xayzyt/STM32_Smart_Car_1.5/README.md

# STM32_Smart_Car_1.5
初学者的第一个小车项目，该小车有超声波跟随，蓝牙控制，超声波避障，红外循迹四个功能，内含原理图及PCB，以及硬件全部资料和软件源码。
