xayzyt/STM32_Smart_Car_1.5/04小车PCB硬件资料(你要的PCB电路板资料)/小车PCB资料_V1.5/02_PCB工程文件_STM32小车V1.5正式版(这是工程文件把这个导入立创就可以修改编辑)/如何使用步骤.docx

1. 登录立创EDA

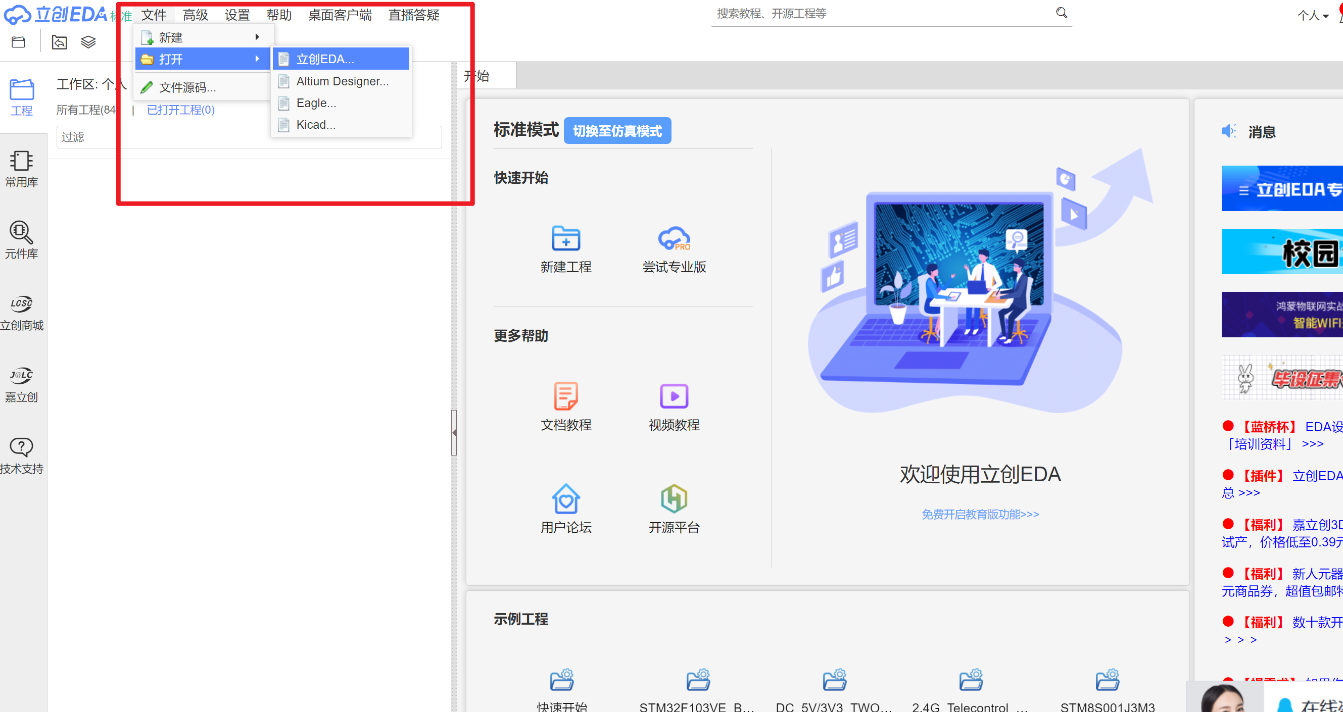
[picture p2: figure]

2. 选择文件

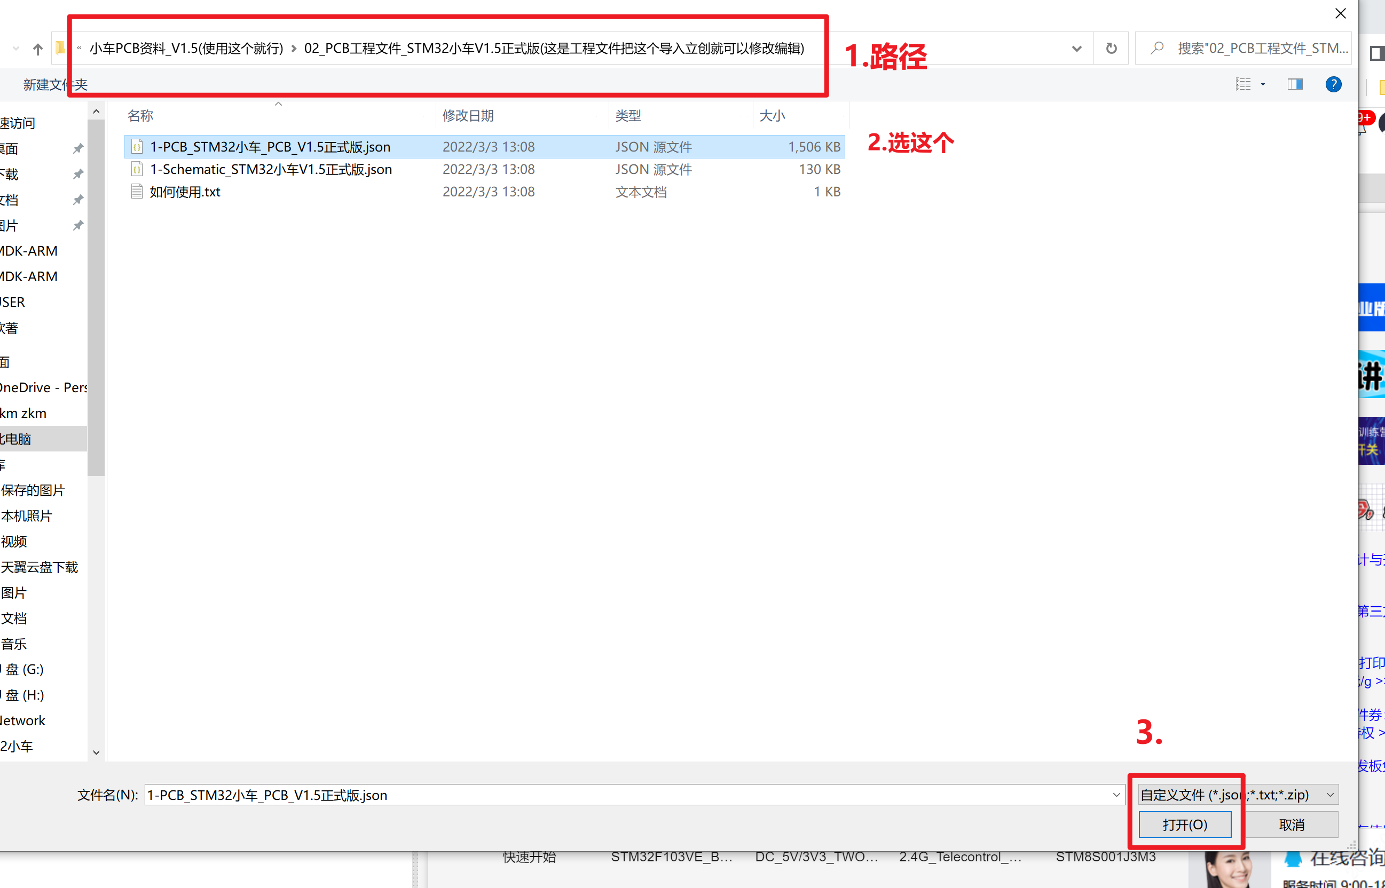
[picture p3: figure]

3. 选择保存新工程里

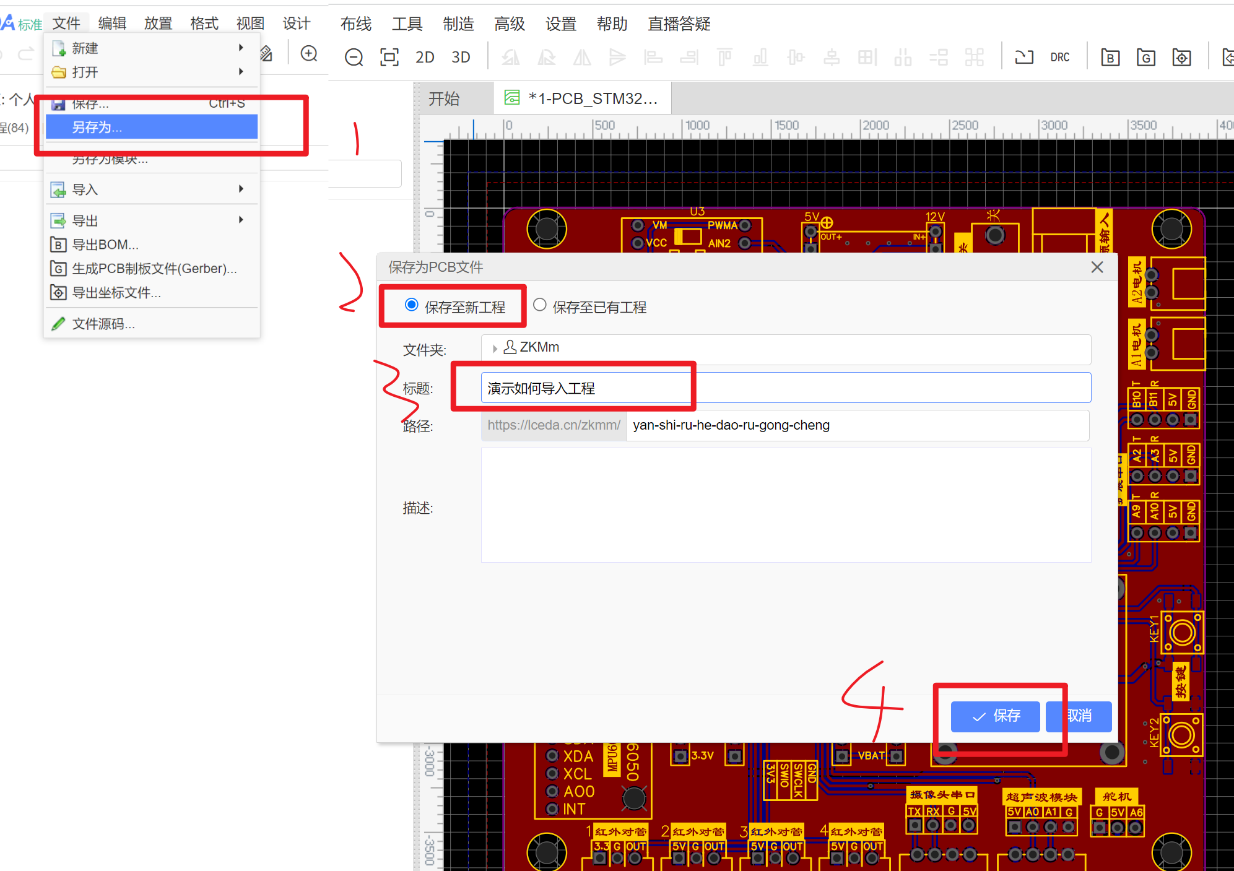
[picture p4: figure]

4. 导入下一原理图

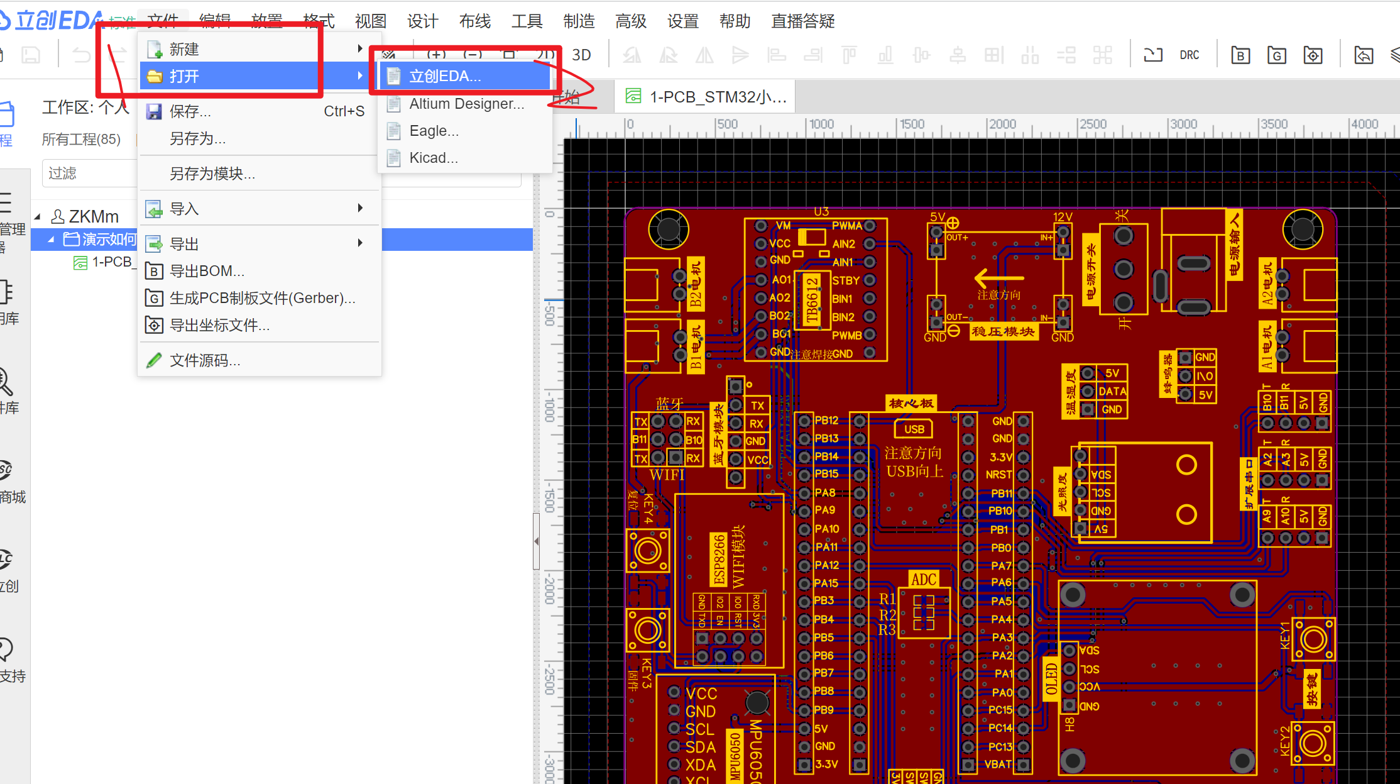
[picture p5: figure]

选择原理图

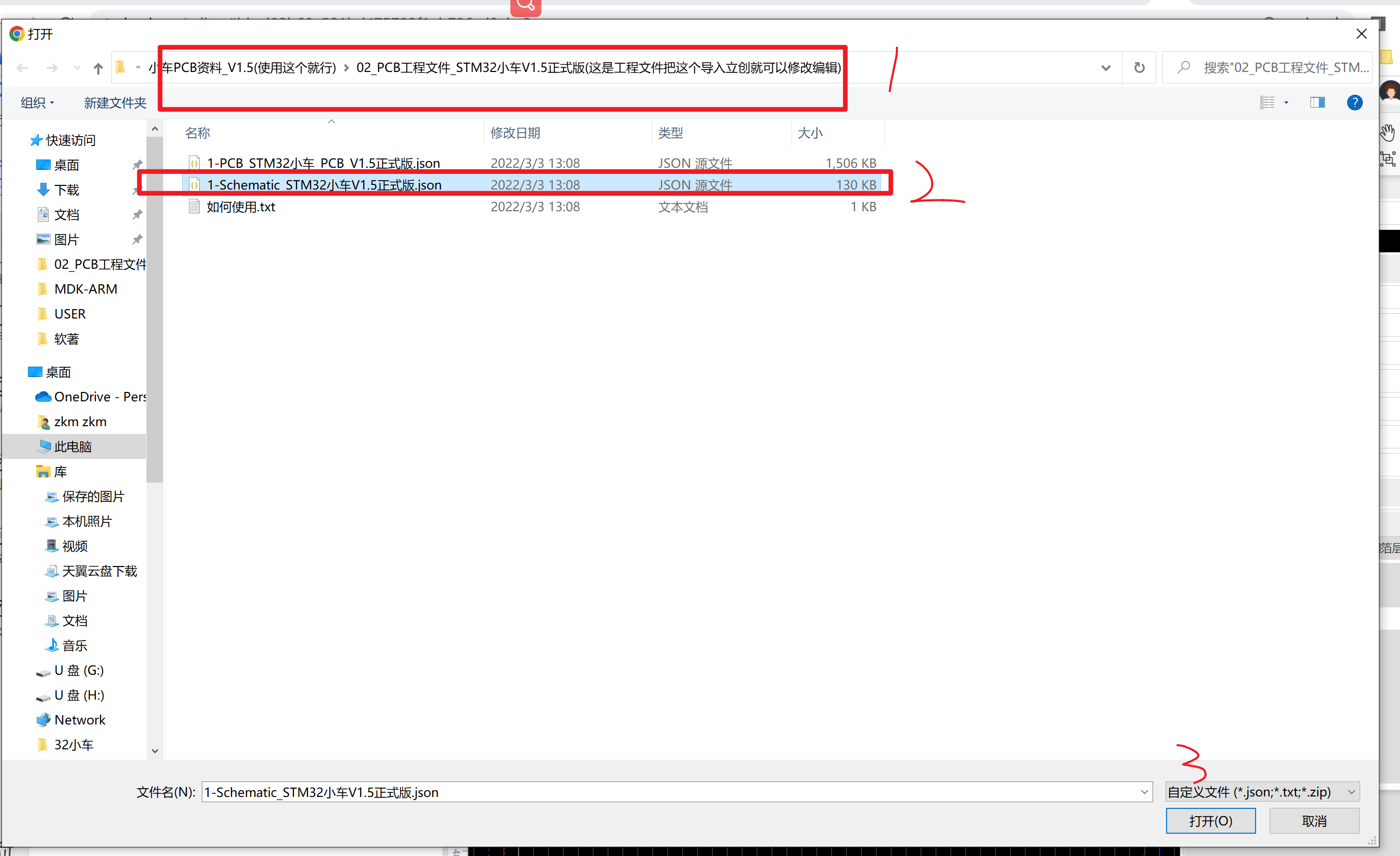
[picture p6: figure]
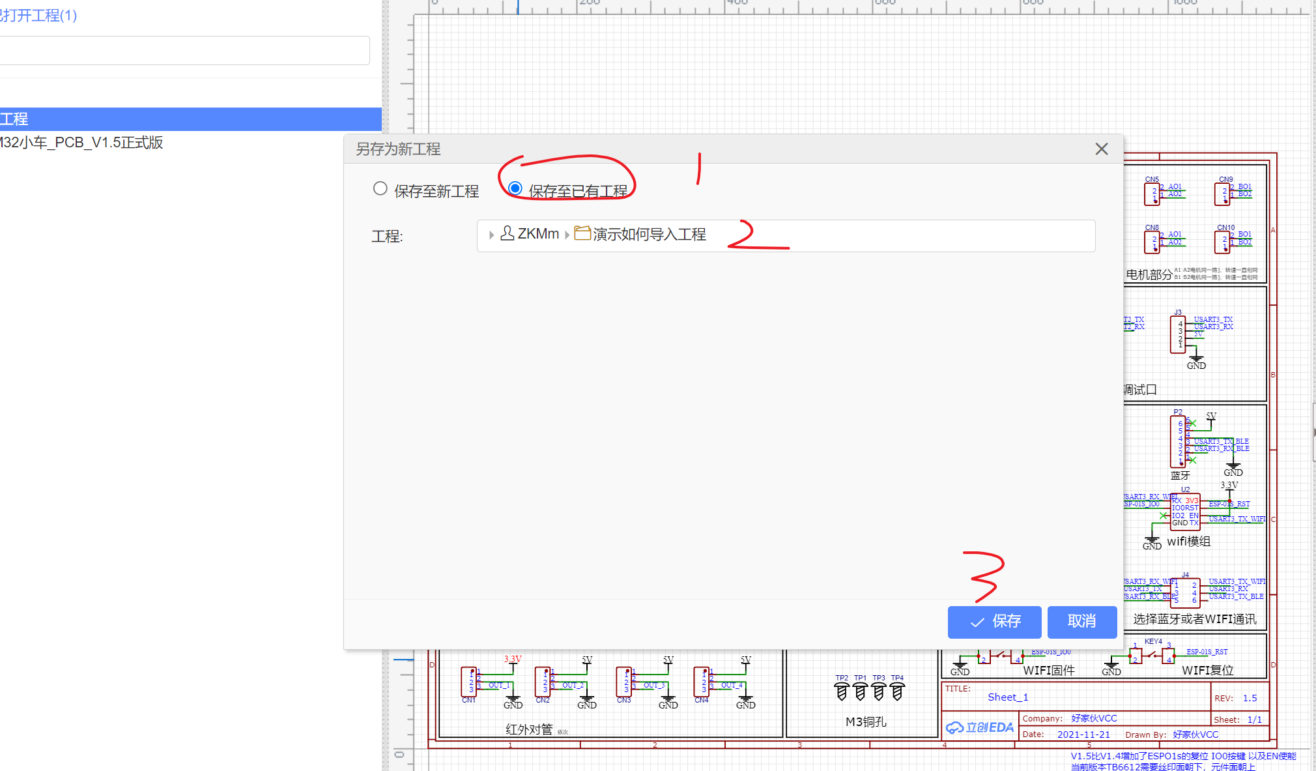
[picture p7: figure]
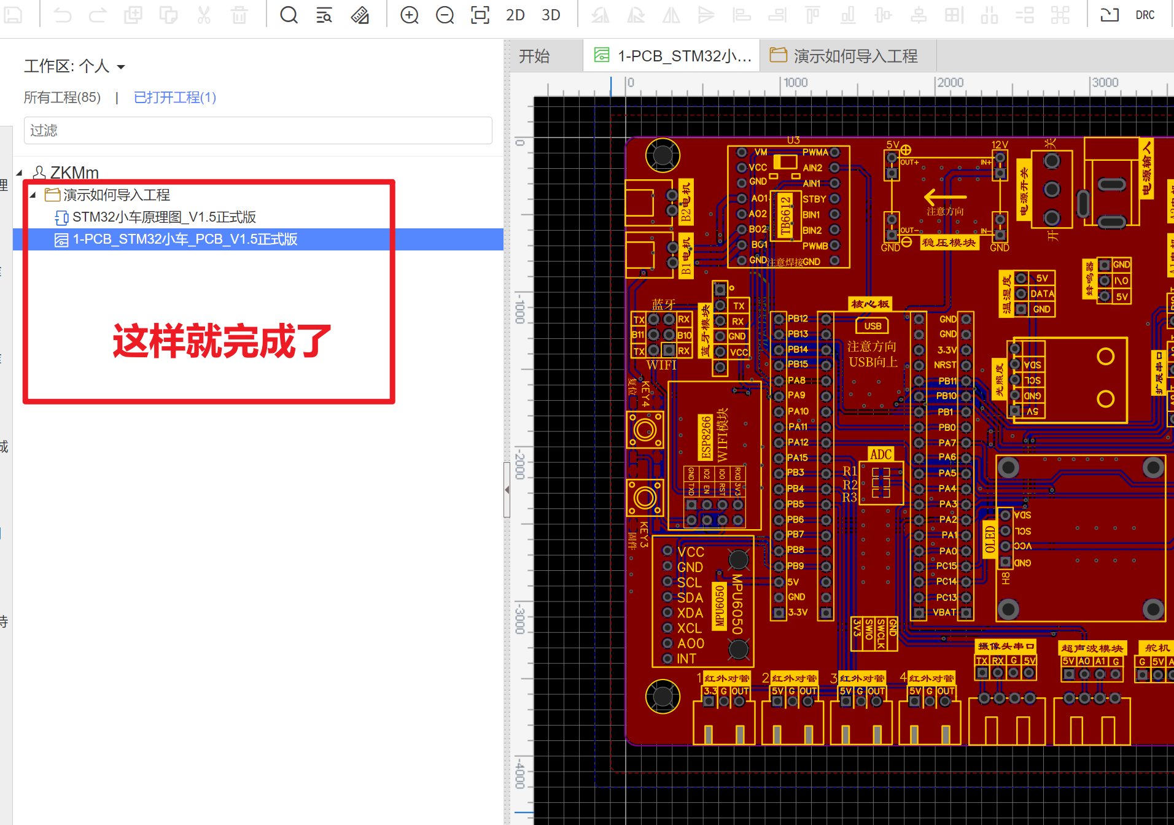
[picture p8: figure]
