xayzyt/STM32_Smart_Car_1.5/04小车PCB硬件资料(你要的PCB电路板资料)/小车PCB资料_V1.5/PCB3D预览(这个图没有什么用).png

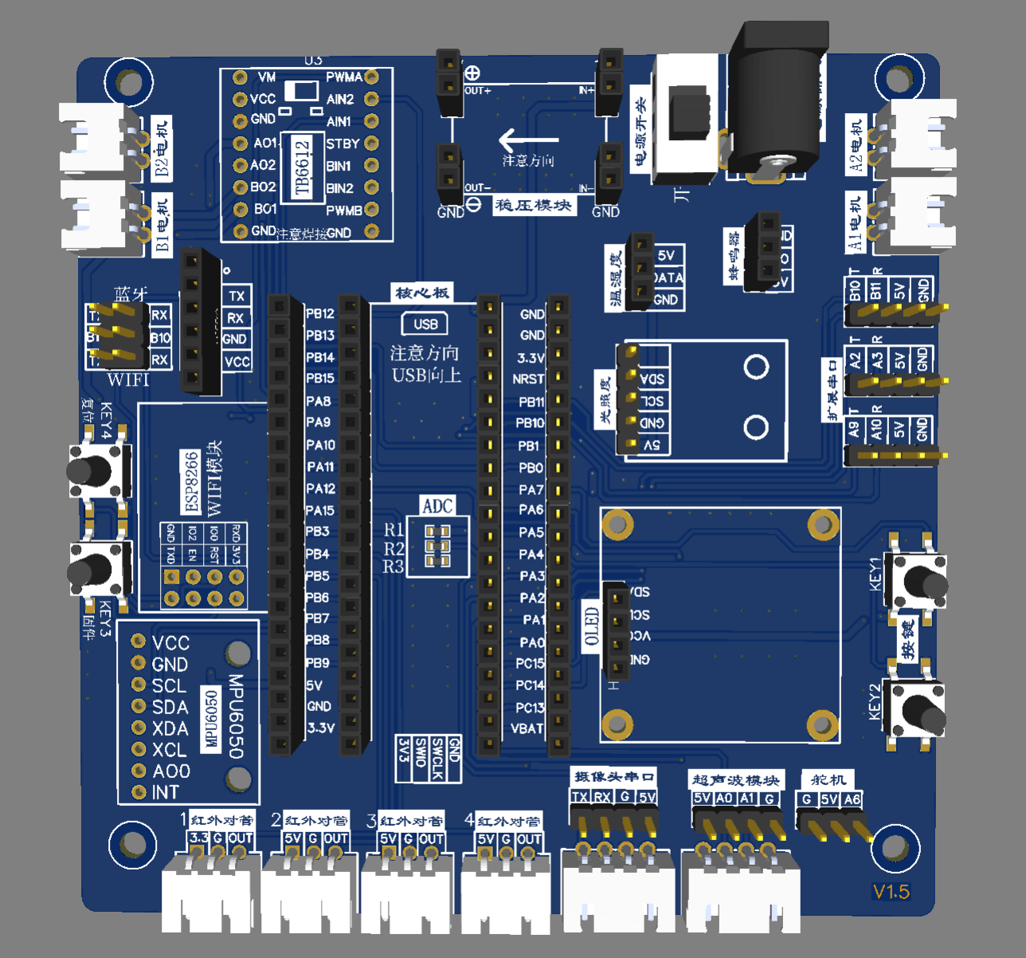
04小车PCB硬件资料(你要的PCB电路板资料)/小车PCB资料_V1.5/PCB3D预览(这个图没有什么用).png
