xayzyt/STM32_Smart_Car_1.5/04小车PCB硬件资料(你要的PCB电路板资料)/小车PCB资料_V1.5/无模块(焊接前大家一定看看这个).png

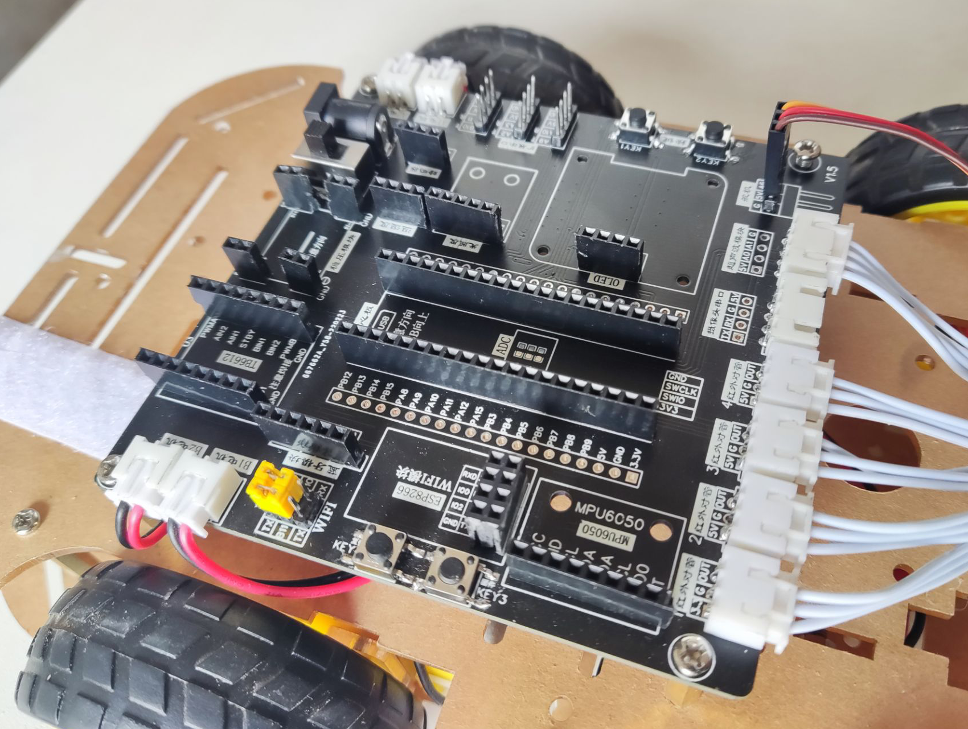
04小车PCB硬件资料(你要的PCB电路板资料)/小车PCB资料_V1.5/无模块(焊接前大家一定看看这个).png
