xayzyt/STM32_Smart_Car_1.5/04小车PCB硬件资料(你要的PCB电路板资料)/小车PCB资料_V1.5/04_所有物料清单(要买的零件都在这里).xlsx

类别 | 元件名称 | 数量 | 型号 | 注意事项
电子模块 | STM32f103c8t6最小系统板 | 1 | 芯片是:STM32F103C8T6!!!(大佬随意) | 也不能买特别便宜的，有的存在问题
 | OLED显示屏模块 0.96寸 IIC/SPI | 1
 | HC-SR04 超声波测距模块 | 1
 | 寻迹传感器 TCRT5000红外反射传感器 | 4 |  | 可以买5个，实际使用4个
 | HC-05 主从机一体蓝牙串口透传模块 | 1 | 要板子带个小按键的方便一点 | 现在买HC-05都是新版，新版用法我在视频补充了
 | TB6612FNG电机驱动模块 | 1
 | DC-DC降压板3A/5A稳压电源模块MP1584 | 1 | 3A降压5V输出 | 一定要大概是这个尺寸：22.3mm*17mm
 | SG90 9g舵机 固定翼航模遥控飞机 180度舵机 | 1 | 一定是180度的
 | 12v锂电池组18650充电带保护板大容量电瓶通用移动电源便携蓄电池 | 1 | 最好带充电器
电源 | 智能小车底盘/寻迹小车/机器人小车底盘/测速/送电池盒2 4 WD小车 |  | 必须带4个电机，双层更好
组装小车结构 | 固定超声波传感器支架 | 1 | HC-SR04 超声波固定支架
 | 常用M3螺丝包 螺母 3*5 3*8 3*10 3*12 3*12 圆头平头螺丝 | 1 | 无(就是架板子用，不买也行)
 | 常用M3 铜柱 包 M3*5 6 8 10 12 15 +6 双通 M3螺母 螺丝 | 1 | 无(就是架板子用，不买也行)
 | SG90舵机支架 | 1 | SG90舵机云台支架
 | XH2.54MM-2P单头连接线 端子线 | 4 | 长度20-30CM左右
线材 | XH2.54 单头电子线 红白排线 长20CM | 4 | 3P 双头长度：20CM左右
 | XH2.54 单头电子线 红白排线 长20CM | 1 | 4P双头长度：20CM左右
 | XH2.54接插件 2.54mm | 4 | 3P 弯针
PCB | XH2.54接插件 2.54mm | 2 | 4P 弯针
 | 母座 弯插/弯针 2.5mm 2Pin位 | 4 | 2P 弯针
 | 间距2.54MM 单排直插母座 | 2 | 间距2.54MM 1*20
 | 间距2.54MM 单排直插母座 | 3 | 间距2.54MM 1*8
 | 间距2.54MM 单排直插母座 | 1 | 间距2.54MM 2*4
 | 双排针 间距2.54MM | 1 | 间距2.54MM 2*3
 | 间距2.54MM 单排直插母座 | 1 | 间距2.54MM 1*6
 | 间距2.54MM 单排直插母座 | 4 | 间距2.54MM 1*2
 | 间距2.54MM 单排直插母座 | 1 | 间距2.54MM 1*4
 | 间距2.54MM 单排直插母座 | 1 | 间距2.54MM 1*5
 | 间距2.54MM 单排直插母座 | 2 | 间距2.54MM 1*3
 | 6*6*7mm 轻触按键 | 4 | 贴片封装 | 至少买4个(V1.5版PCB焊接4个，如果V1.4就两个就行)
 | DC电源插座 内径:2mm 外径:6.3mm | 1 | 插件
 | 滑动开关 插件大电流拨动开关 SS-12D10L2.5 | 1 | 插件
 | 0603封装20K电阻 | 2 | 贴片封装
 | 0603封装10K电阻 | 1 | 贴片封装
 | 跳线帽 短路帽 间距2.54MM | 2 | 无
 | 单排针 间距2.54MM | 2 | 间距2.54MM 1*10 | 排针是可以自己掰的，比如这个掰成1*2的焊接在稳压电源模块上
调试与烧录工具 | ST-LINK V2 STM8/STM32仿真器编程器 | 1 | ST-LINK V2(第一次使用需要在电脑安装驱动) | 这是下载程序用的(提高调试效率)
 | USB转TTL CH340模块 USB转串口 | 1 | 第一次使用需要在电脑安装驱动 | 这个是单片机和电脑串口通讯使用(调试串口必备)
 | 杜邦线 母对母 公对母公对公40P彩色排线连接线10/15/30/20/40CM | 1 | 母对母30CM 10根以上
胶带 | 用黑的可以做循迹赛道
