xayzyt/STM32_Smart_Car_1.5/05小车结构组装资料/PCB和超声波安装.png

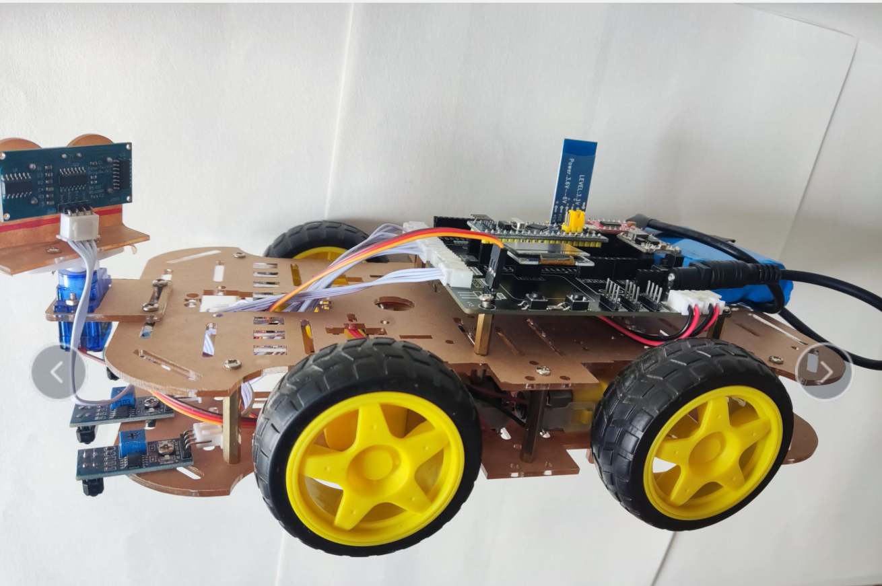
05小车结构组装资料/PCB和超声波安装.png
