xayzyt/STM32_Smart_Car_1.5/05小车结构组装资料/红外对管安装.png

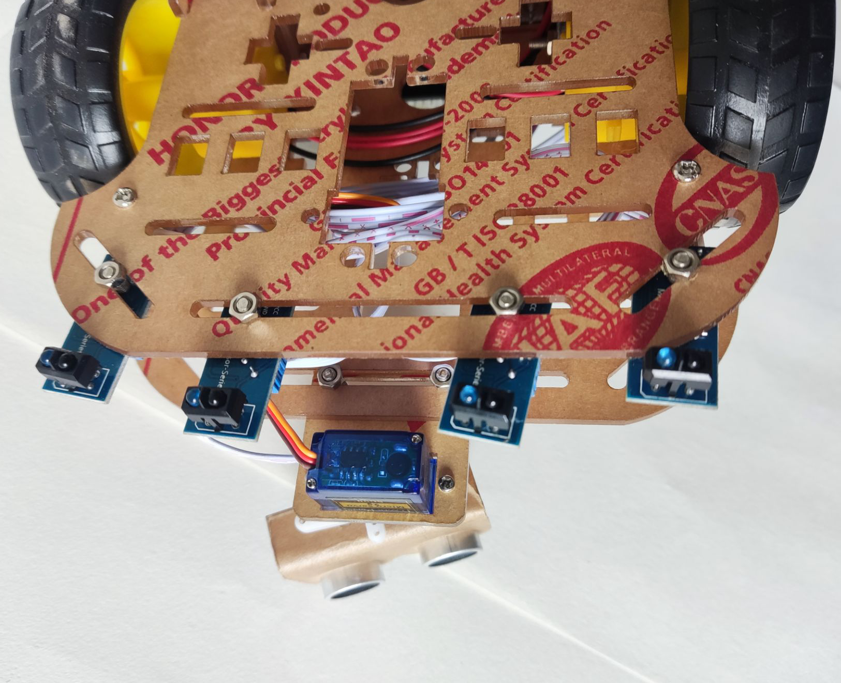
05小车结构组装资料/红外对管安装.png
