xayzyt/STM32_Smart_Car_1.5/05小车结构组装资料/组装好的侧视图.png

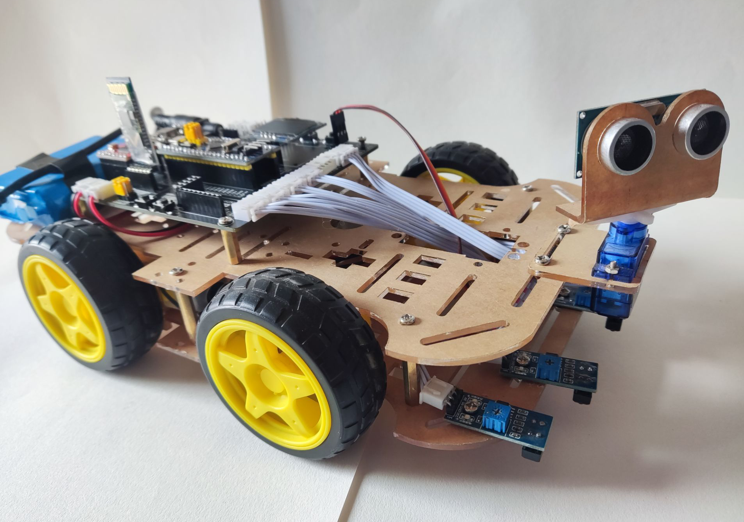
05小车结构组装资料/组装好的侧视图.png
