xayzyt/STM32_Smart_Car_1.5/04小车PCB硬件资料(你要的PCB电路板资料)/小车PCB资料_V1.5/01_原理图_STM32小车V1.5正式版.pdf

5V

## GND

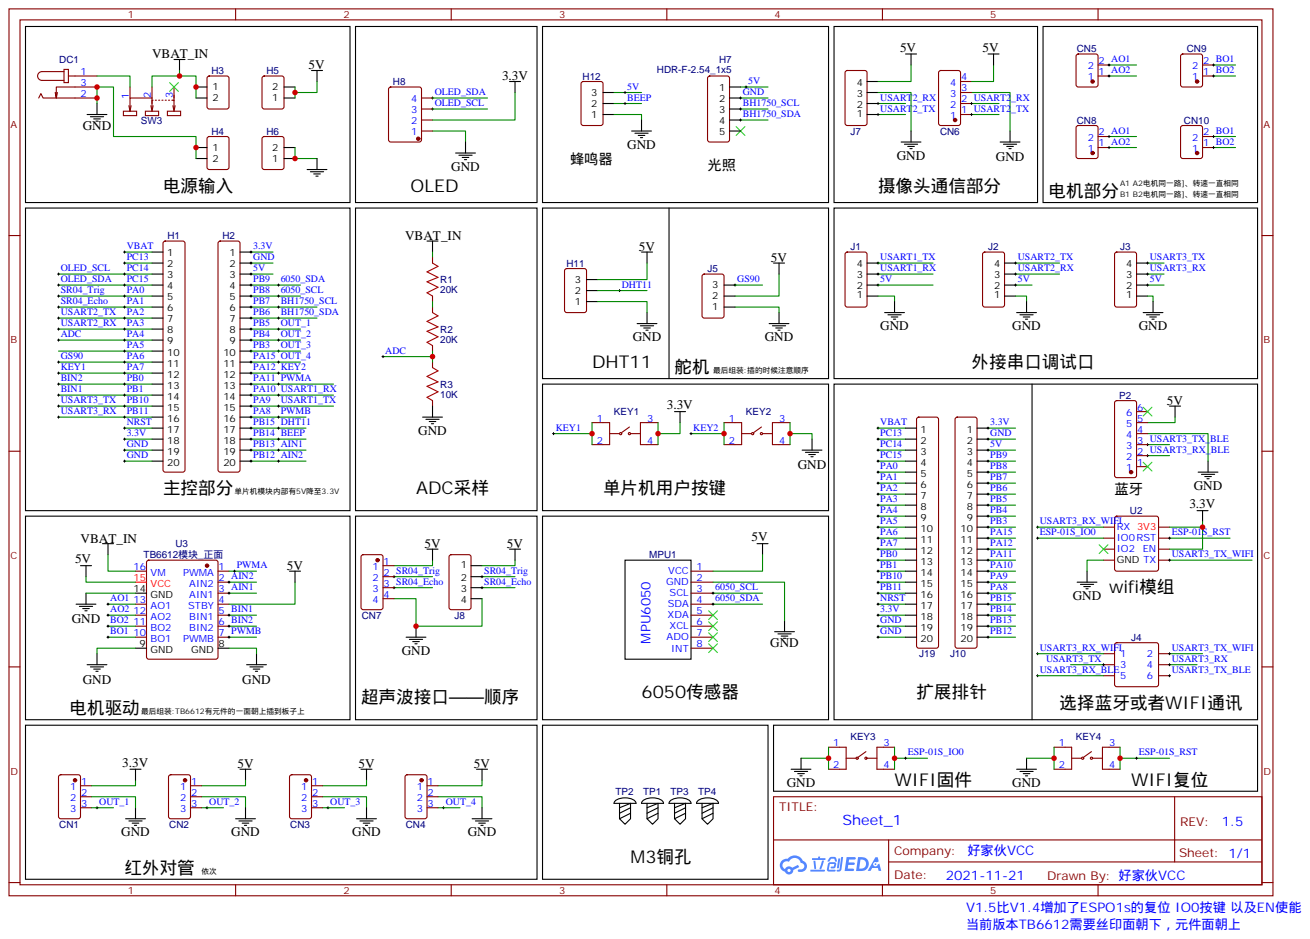
[picture p15: page 1]
