xayzyt/STM32_Smart_Car_1.5/01程序资料/HARDWARE/TIMER/timer.c

#include "timer.h"
#include "led.h"
#include "usart.h"
#include "delay.h"


void TIM3_Int_Init(u16 arr,u16 psc)
{
  TIM_TimeBaseInitTypeDef  TIM_TimeBaseStructure;
	NVIC_InitTypeDef NVIC_InitStructure;

	RCC_APB1PeriphClockCmd(RCC_APB1Periph_TIM3, ENABLE); //时钟使能

	TIM_TimeBaseStructure.TIM_Period = arr; //设置在下一个更新事件装入活动的自动重装载寄存器周期的值	 计数到5000为500ms
	TIM_TimeBaseStructure.TIM_Prescaler =psc; //设置用来作为TIMx时钟频率除数的预分频值  10Khz的计数频率  
	TIM_TimeBaseStructure.TIM_ClockDivision = 0; //设置时钟分割:TDTS = Tck_tim
	TIM_TimeBaseStructure.TIM_CounterMode = TIM_CounterMode_Up;  //TIM向上计数模式
	TIM_TimeBaseInit(TIM3, &TIM_TimeBaseStructure); //根据TIM_TimeBaseInitStruct中指定的参数初始化TIMx的时间基数单位
 
	TIM_ITConfig(TIM3,TIM_IT_Update,ENABLE ); //使能指定的TIM3中断,允许更新中断

	NVIC_InitStructure.NVIC_IRQChannel = TIM3_IRQn;  //TIM3中断
	NVIC_InitStructure.NVIC_IRQChannelPreemptionPriority = 0;  //先占优先级0级
	NVIC_InitStructure.NVIC_IRQChannelSubPriority = 3;  //从优先级3级
	NVIC_InitStructure.NVIC_IRQChannelCmd = ENABLE; //IRQ通道被使能
	NVIC_Init(&NVIC_InitStructure);  //根据NVIC_InitStruct中指定的参数初始化外设NVIC寄存器

	TIM_Cmd(TIM3, ENABLE);  //使能TIMx外设
							 
}
//定时器3中断服务程序
void TIM3_IRQHandler(void)   //TIM3中断
{
	if (TIM_GetITStatus(TIM3, TIM_IT_Update) != RESET) //检查指定的TIM中断发生与否:TIM 中断源 
		{
		TIM_ClearITPendingBit(TIM3, TIM_IT_Update  );  //清除TIMx的中断待处理位:TIM 中断源 
		
		}
}




//舵机TIM3 PWM部分初始化 
//PWM输出初始化
//arr：自动重装值
//psc：时钟预分频数
void TIM3_PWM_Init(u16 arr,u16 psc)
{  
	GPIO_InitTypeDef GPIO_InitStructure;
	TIM_TimeBaseInitTypeDef  TIM_TimeBaseStructure;
	TIM_OCInitTypeDef  TIM_OCInitStructure;
	

	RCC_APB1PeriphClockCmd(RCC_APB1Periph_TIM3, ENABLE);	//使能定时器3时钟
 	RCC_APB2PeriphClockCmd(RCC_APB2Periph_GPIOA  | RCC_APB2Periph_AFIO, ENABLE);  //使能GPIO外设和AFIO复用功能模块时钟
	
 
 
   //设置该引脚为复用输出功能,输出TIM3 CH1的PWM脉冲波形	GPIOA.6
	GPIO_InitStructure.GPIO_Pin = GPIO_Pin_6; //TIM3_CH1
	GPIO_InitStructure.GPIO_Mode = GPIO_Mode_AF_PP;  //复用推挽输出
	GPIO_InitStructure.GPIO_Speed = GPIO_Speed_50MHz;
	GPIO_Init(GPIOA, &GPIO_InitStructure);//初始化GPIO
 
   //初始化TIM3
	TIM_TimeBaseStructure.TIM_Period = arr; //设置在下一个更新事件装入活动的自动重装载寄存器周期的值
	TIM_TimeBaseStructure.TIM_Prescaler =psc; //设置用来作为TIMx时钟频率除数的预分频值 
	TIM_TimeBaseStructure.TIM_ClockDivision = 0; //设置时钟分割:TDTS = Tck_tim
	TIM_TimeBaseStructure.TIM_CounterMode = TIM_CounterMode_Up;  //TIM向上计数模式
	TIM_TimeBaseInit(TIM3, &TIM_TimeBaseStructure); //根据TIM_TimeBaseInitStruct中指定的参数初始化TIMx的时间基数单位
	
	//初始化TIM3 Channel1 PWM模式	 
	TIM_OCInitStructure.TIM_OCMode = TIM_OCMode_PWM2; //选择定时器模式:TIM脉冲宽度调制模式2
 	TIM_OCInitStructure.TIM_OutputState = TIM_OutputState_Enable; //比较输出使能
	TIM_OCInitStructure.TIM_OCPolarity = TIM_OCPolarity_Low; //输出极性:TIM输出比较极性低
	TIM_OC1Init(TIM3, &TIM_OCInitStructure);  //根据T指定的参数初始化外设TIM3 OC1

	TIM_OC1PreloadConfig(TIM3, TIM_OCPreload_Enable);  //使能TIM3在CCR1上的预装载寄存器
 
	TIM_Cmd(TIM3, ENABLE);  //使能TIM3
	

}


//TIM1 PWM部分初始化 
//PWM输出初始化
//arr：自动重装值
//psc：时钟预分频数
void TIM1_PWM_Init(u16 arr,u16 psc)
{  
	GPIO_InitTypeDef GPIO_InitStructure;
	TIM_TimeBaseInitTypeDef  TIM_TimeBaseStructure;
	TIM_OCInitTypeDef  TIM_OCInitStructure;
	

	RCC_APB2PeriphClockCmd(RCC_APB2Periph_TIM1, ENABLE);	//使能定时器1时钟
 	RCC_APB2PeriphClockCmd(RCC_APB2Periph_GPIOA  | RCC_APB2Periph_AFIO, ENABLE);  //使能GPIO外设和AFIO复用功能模块时钟
	
	//设置该引脚为复用输出功能,输出TIM1 CH1的PWM脉冲波形	GPIOA.8
	GPIO_InitStructure.GPIO_Pin = GPIO_Pin_8; //TIM1_CH1
	GPIO_InitStructure.GPIO_Mode = GPIO_Mode_AF_PP;  //复用推挽输出
	GPIO_InitStructure.GPIO_Speed = GPIO_Speed_50MHz;
	GPIO_Init(GPIOA, &GPIO_InitStructure);//初始化GPIO
 
   //设置该引脚为复用输出功能,输出TIM1 CH4的PWM脉冲波形	GPIOA.11
	GPIO_InitStructure.GPIO_Pin = GPIO_Pin_11; //TIM1_CH4
	GPIO_InitStructure.GPIO_Mode = GPIO_Mode_AF_PP;  //复用推挽输出
	GPIO_InitStructure.GPIO_Speed = GPIO_Speed_50MHz;
	GPIO_Init(GPIOA, &GPIO_InitStructure);//初始化GPIO
  
 
   //初始化TIM1时基单元
	TIM_TimeBaseStructure.TIM_Period = arr; //设置在下一个更新事件装入活动的自动重装载寄存器周期的值
	TIM_TimeBaseStructure.TIM_Prescaler =psc; //设置用来作为TIMx时钟频率除数的预分频值 
	TIM_TimeBaseStructure.TIM_ClockDivision = 0; //设置时钟分割:TDTS = Tck_tim
	TIM_TimeBaseStructure.TIM_CounterMode = TIM_CounterMode_Up;  //TIM向上计数模式
	TIM_TimeBaseInit(TIM1, &TIM_TimeBaseStructure); //根据TIM_TimeBaseInitStruct中指定的参数初始化TIMx的时间基数单位
	
	//初始化TIM1 Channel1 PWM模式	 
	TIM_OCInitStructure.TIM_OCMode = TIM_OCMode_PWM2; //选择定时器模式:TIM脉冲宽度调制模式2
 	TIM_OCInitStructure.TIM_OutputState = TIM_OutputState_Enable; //比较输出使能
	TIM_OCInitStructure.TIM_OCPolarity = TIM_OCPolarity_High; //输出极性:TIM输出比较极性高
	TIM_OC1Init(TIM1, &TIM_OCInitStructure);  //根据T指定的参数初始化外设TIM3 OC2

	TIM_OC1PreloadConfig(TIM1, TIM_OCPreload_Enable);  //使能TIM1在CCR1上的预装载寄存器
 
 
	//初始化TIM1 Channel4 PWM模式	 
	TIM_OCInitStructure.TIM_OCMode = TIM_OCMode_PWM2; //选择定时器模式:TIM脉冲宽度调制模式2
 	TIM_OCInitStructure.TIM_OutputState = TIM_OutputState_Enable; //比较输出使能
	TIM_OCInitStructure.TIM_OCPolarity = TIM_OCPolarity_High; //输出极性:TIM输出比较极性高
	TIM_OC4Init(TIM1, &TIM_OCInitStructure);  //根据T指定的参数初始化外设TIM1 OC4

	TIM_OC4PreloadConfig(TIM1, TIM_OCPreload_Enable);  //使能TIM1在CCR4上的预装载寄存器
	
	TIM_Cmd(TIM1, ENABLE);  //使能TIM1
	TIM_CtrlPWMOutputs(TIM1,ENABLE);			//高级定时器必须加
	

}



//定时器2通道2输入捕获配置



void TIM2_Cap_Init(u16 arr,u16 psc)
{	 
	
	TIM_TimeBaseInitTypeDef  TIM_TimeBaseStructure;
	GPIO_InitTypeDef GPIO_InitStructure;
	TIM_ICInitTypeDef  TIM2_ICInitStructure;
   	NVIC_InitTypeDef NVIC_InitStructure;

	RCC_APB1PeriphClockCmd(RCC_APB1Periph_TIM2, ENABLE);	//使能TIM2时钟
 	RCC_APB2PeriphClockCmd(RCC_APB2Periph_GPIOA, ENABLE);  //使能GPIOA时钟
	
	
	
	GPIO_InitStructure.GPIO_Pin  = GPIO_Pin_1;  //PA1 
	GPIO_InitStructure.GPIO_Mode = GPIO_Mode_IPD; //PA1 输入  
	GPIO_Init(GPIOA, &GPIO_InitStructure);
	GPIO_ResetBits(GPIOA,GPIO_Pin_1);						 //PA1 下拉
	
	//初始化定时器2 TIM2	 
	TIM_TimeBaseStructure.TIM_Period = arr; //设定计数器自动重装值 
	TIM_TimeBaseStructure.TIM_Prescaler =psc; 	//预分频器   
	TIM_TimeBaseStructure.TIM_ClockDivision = TIM_CKD_DIV1; //设置时钟分割:TDTS = Tck_tim
	TIM_TimeBaseStructure.TIM_CounterMode = TIM_CounterMode_Up;  //TIM向上计数模式
	TIM_TimeBaseInit(TIM2, &TIM_TimeBaseStructure); //根据TIM_TimeBaseInitStruct中指定的参数初始化TIMx的时间基数单位
  
	//初始化TIM2输入捕获参数

	TIM2_ICInitStructure.TIM_Channel = TIM_Channel_2; //CC1S=01 	选择输入端 IC1映射到TI2上
  	TIM2_ICInitStructure.TIM_ICPolarity = TIM_ICPolarity_Rising;	//上升沿捕获
  	TIM2_ICInitStructure.TIM_ICSelection = TIM_ICSelection_DirectTI; //映射到TI1上
  	TIM2_ICInitStructure.TIM_ICPrescaler = TIM_ICPSC_DIV1;	 //配置输入分频,不分频 
  	TIM2_ICInitStructure.TIM_ICFilter = 0x00;//IC1F=0000 配置输入滤波器 不滤波
  	TIM_ICInit(TIM2, &TIM2_ICInitStructure);
	
	//中断分组初始化
	NVIC_InitStructure.NVIC_IRQChannel = TIM2_IRQn;  //TIM2中断
	NVIC_InitStructure.NVIC_IRQChannelPreemptionPriority = 2;  //先占优先级2级
	NVIC_InitStructure.NVIC_IRQChannelSubPriority = 0;  //从优先级0级
	NVIC_InitStructure.NVIC_IRQChannelCmd = ENABLE; //IRQ通道被使能
	NVIC_Init(&NVIC_InitStructure);  //根据NVIC_InitStruct中指定的参数初始化外设NVIC寄存器 
	
	TIM_ITConfig(TIM2,TIM_IT_Update|TIM_IT_CC2,ENABLE);//允许更新中断 ,允许CC1IE捕获中断	
	
   	TIM_Cmd(TIM2,ENABLE ); 	//使能定时器2
   


}

u8  TIM2CH2_CAPTURE_STA=0;	//输入捕获状态		    				
u16	TIM2CH2_CAPTURE_VAL;	//输入捕获值
 
//定时器2中断服务程序	 
void TIM2_IRQHandler(void)
{ 

 	if((TIM2CH2_CAPTURE_STA&0X80)==0)//还未成功捕获	
	{	  
		if (TIM_GetITStatus(TIM2, TIM_IT_Update) != RESET)
		 
		{	    
			if(TIM2CH2_CAPTURE_STA&0X40)//已经捕获到高电平了
			{
				if((TIM2CH2_CAPTURE_STA&0X3F)==0X3F)//高电平太长了
				{
					TIM2CH2_CAPTURE_STA|=0X80;//标记成功捕获了一次
					TIM2CH2_CAPTURE_VAL=0XFFFF;
				}else TIM2CH2_CAPTURE_STA++;
			}	 
		}
		if (TIM_GetITStatus(TIM2, TIM_IT_CC2) != RESET)//捕获2发生捕获事件
			{	
				if(TIM2CH2_CAPTURE_STA&0X40)		//捕获到一个下降沿 		
				{	  			
					TIM2CH2_CAPTURE_STA|=0X80;		//标记成功捕获到一次上升沿
					TIM2CH2_CAPTURE_VAL=TIM_GetCapture2(TIM2);
					TIM_OC2PolarityConfig(TIM2,TIM_ICPolarity_Rising); //CC2P=0 设置为上升沿捕获
				}else  								//还未开始,第一次捕获上升沿
				{
					TIM2CH2_CAPTURE_STA=0;			//清空
					TIM2CH2_CAPTURE_VAL=0;
					TIM_SetCounter(TIM2,0);
					TIM2CH2_CAPTURE_STA|=0X40;		//标记捕获到了上升沿
					TIM_OC2PolarityConfig(TIM2,TIM_ICPolarity_Falling);		//CC2P=1 设置为下降沿捕获
				}		    
			}			     	    					   
 	}
 
    TIM_ClearITPendingBit(TIM2, TIM_IT_CC2|TIM_IT_Update); //清除中断标志位
 
}

int SR04_Distance(void)
{
	delay_ms(500);
			 SR04 = 1;
			 delay_us(13);
			 SR04 = 0;
			if(TIM2CH2_CAPTURE_STA&0X80)//成功捕获到了一次上升沿
			{
				time=TIM2CH2_CAPTURE_STA&0X3F;
				time*=65536;//溢出时间总和
				time+=TIM2CH2_CAPTURE_VAL;//得到总的高电平时间
				Distance = time*0.033/2;
				TIM2CH2_CAPTURE_STA=0;//开启下一次捕获
				
			}

			return Distance;
}
