xayzyt/STM32_Smart_Car_1.5/01程序资料/HARDWARE/TIMER/timer.h

#ifndef __TIMER_H
#define __TIMER_H
#include "sys.h"

extern int time;
extern int Distance;
extern uint8_t string[10];

void TIM3_Int_Init(u16 arr,u16 psc);
void TIM3_PWM_Init(u16 arr,u16 psc);
void TIM1_PWM_Init(u16 arr,u16 psc);
void TIM2_Cap_Init(u16 arr,u16 psc);
int SR04_Distance(void);
#endif
