xayzyt/STM32_Smart_Car_1.5/01程序资料/SYSTEM/usart/usart.h

#ifndef __USART_H
#define __USART_H
#include "stdio.h"	
#include "sys.h" 

#define USART_REC_LEN  			200  	//定义最大接收字节数 200
#define EN_USART1_RX 			1		//使能（1）/禁止（0）串口1接收
	  	
extern u8  USART_RX_BUF[USART_REC_LEN]; //接收缓冲,最大USART_REC_LEN个字节.末字节为换行符 
extern u16 USART_RX_STA;         		//接收状态标记	
extern int g_USART1_FLAG;
extern int g_USART3_FLAG;
extern int Mode;
//如果想串口中断接收，请不要注释以下宏定义
void uart1_init(u32 bound);
void uart3_init(u32 bound);
void UsartPrintf(USART_TypeDef * USARTx,char * fmt ,...);
#endif
